bg6jji/si4732Radio/SI4732_MEGA1284/TYPEC接口.png

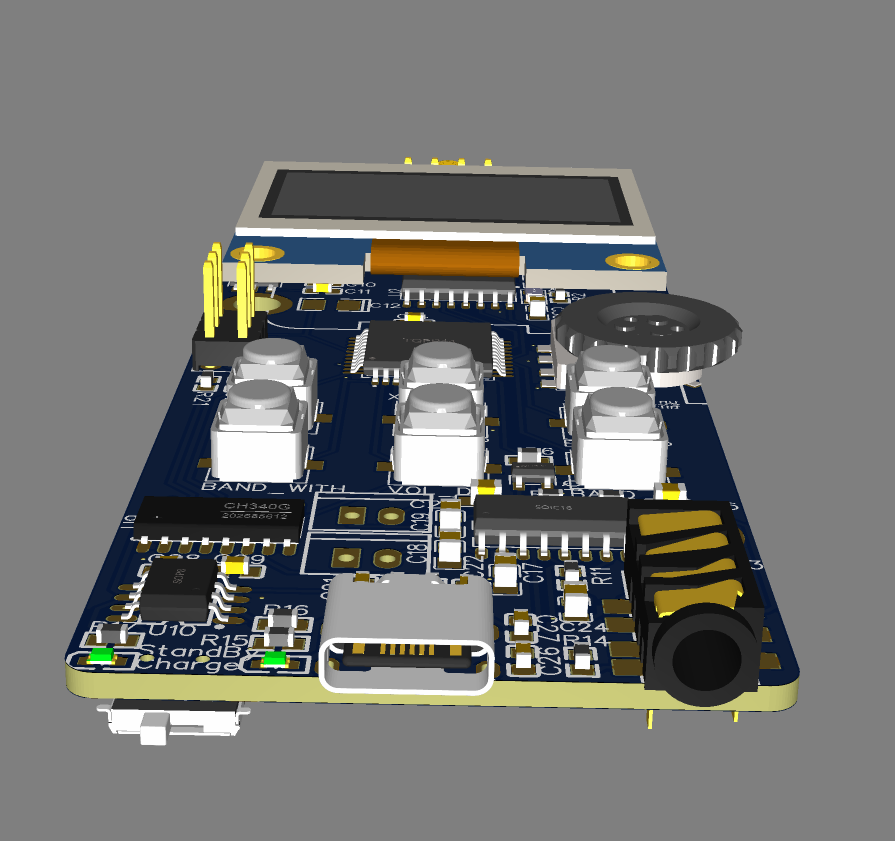
SI4732_MEGA1284/TYPEC接口.png
