bg6jji/si4732Radio/SI4732_MEGA1284/侧面.png

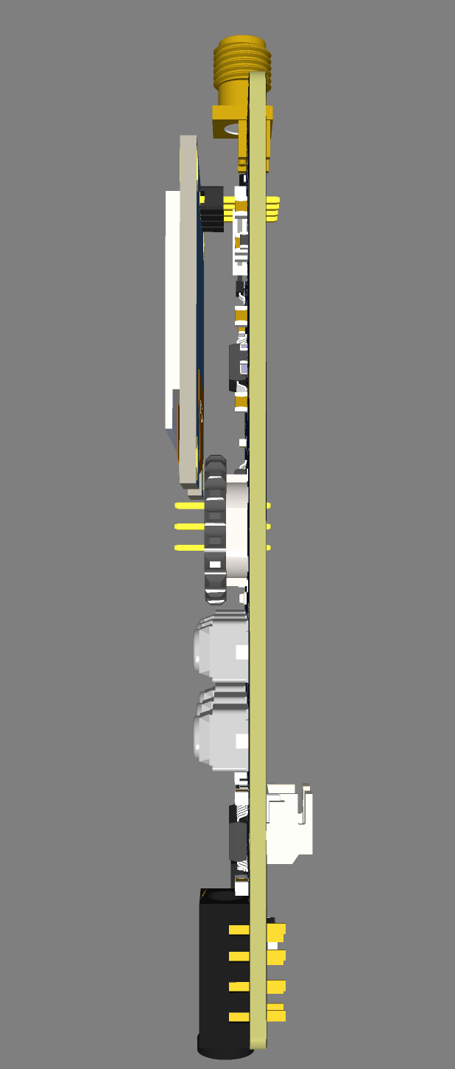
SI4732_MEGA1284/侧面.png
