bg6jji/si4732Radio/SI4732_MEGA1284/天线接口.png

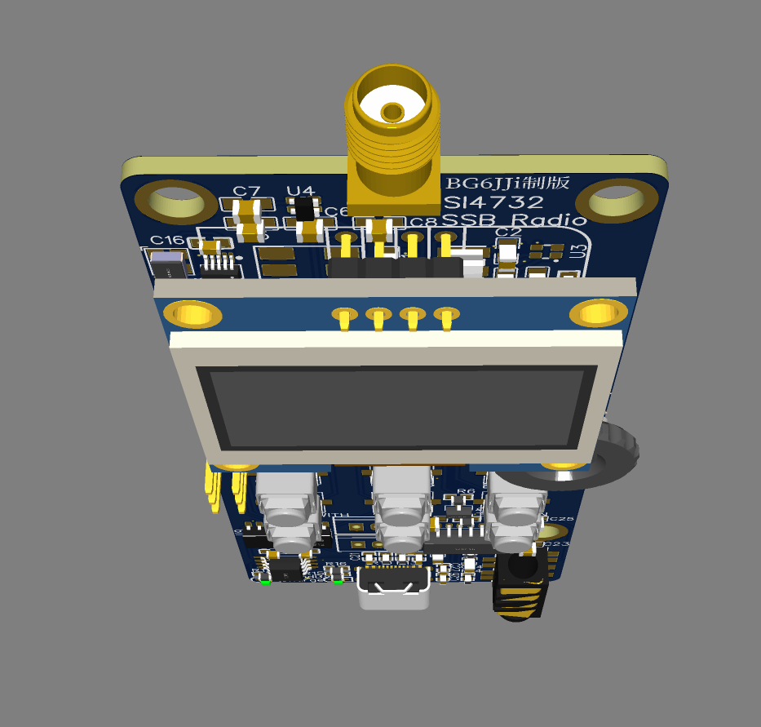
SI4732_MEGA1284/天线接口.png
