bg6jji/si4732Radio/SI4732_MEGA1284/背面.png

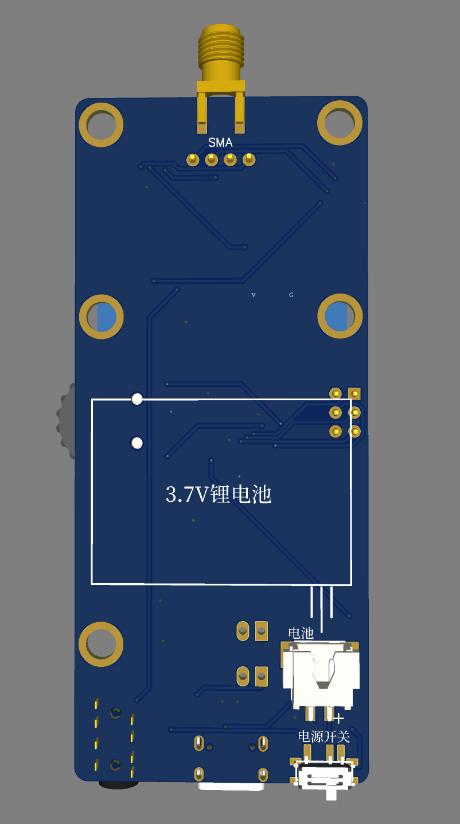
SI4732_MEGA1284/背面.png
