bg6jji/si4732Radio/第一版照片参考/侧面.png

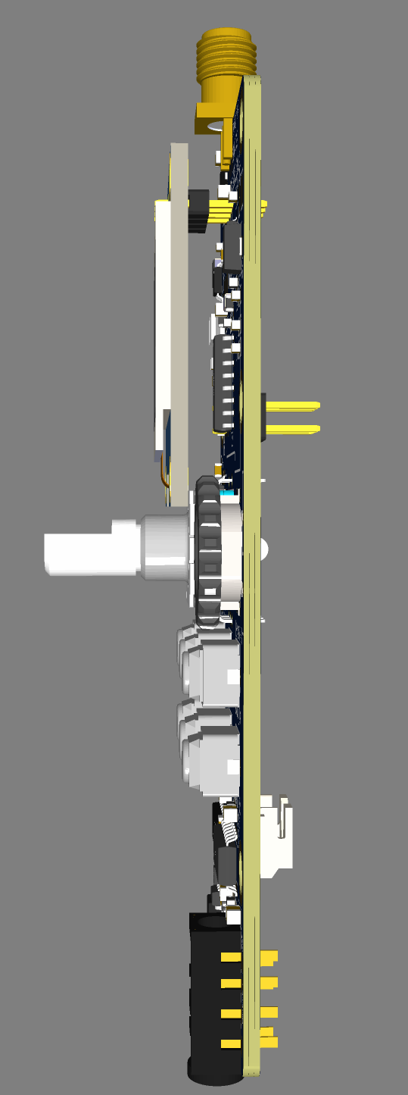
第一版照片参考/侧面.png
