bg6jji/si4732Radio/第一版照片参考/实物照片1.jpg

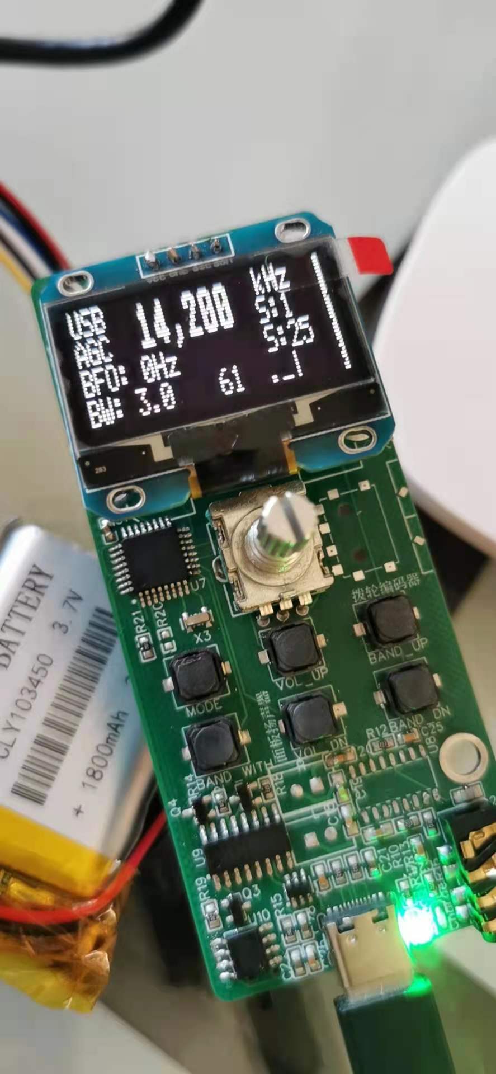
第一版照片参考/实物照片1.jpg
