bg6jji/si4732Radio/第一版照片参考/底部插口.png

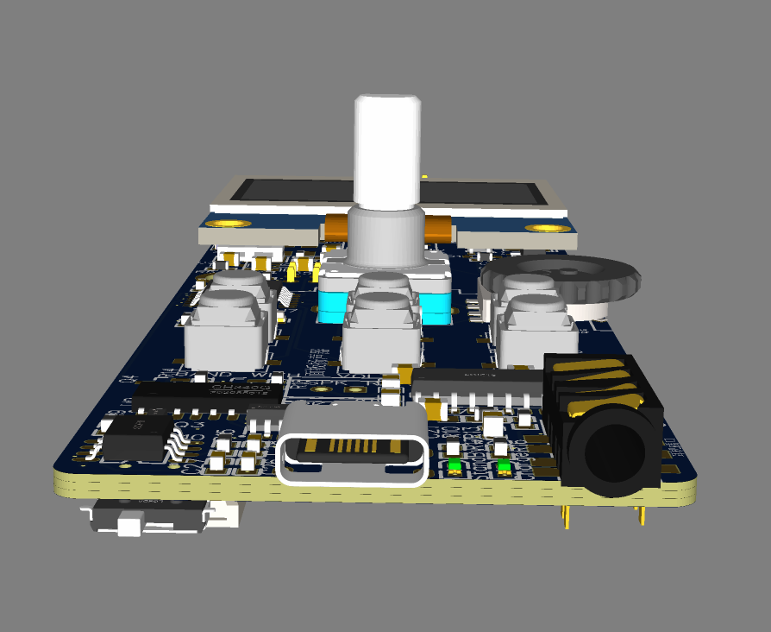
第一版照片参考/底部插口.png
