bg6jji/si4732Radio/第一版照片参考/正面实物图.jpg

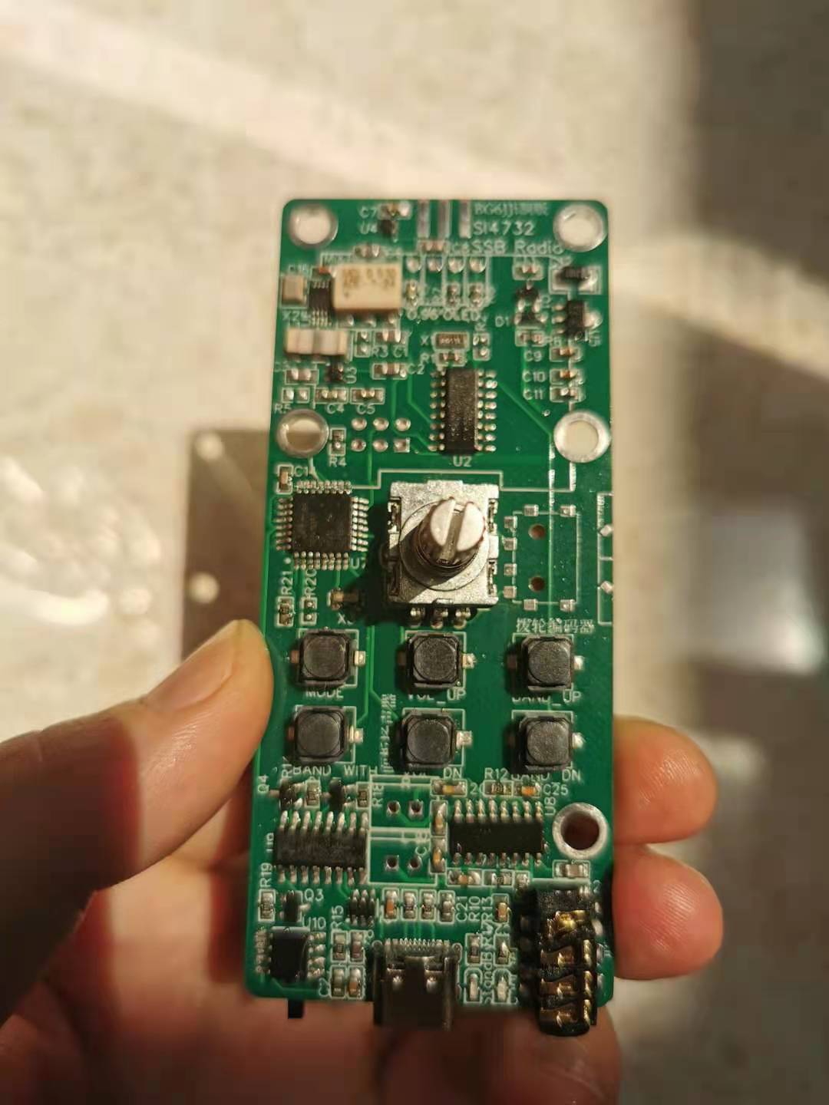
第一版照片参考/正面实物图.jpg
