bg6jji/si4732Radio/第一版照片参考/背面.png

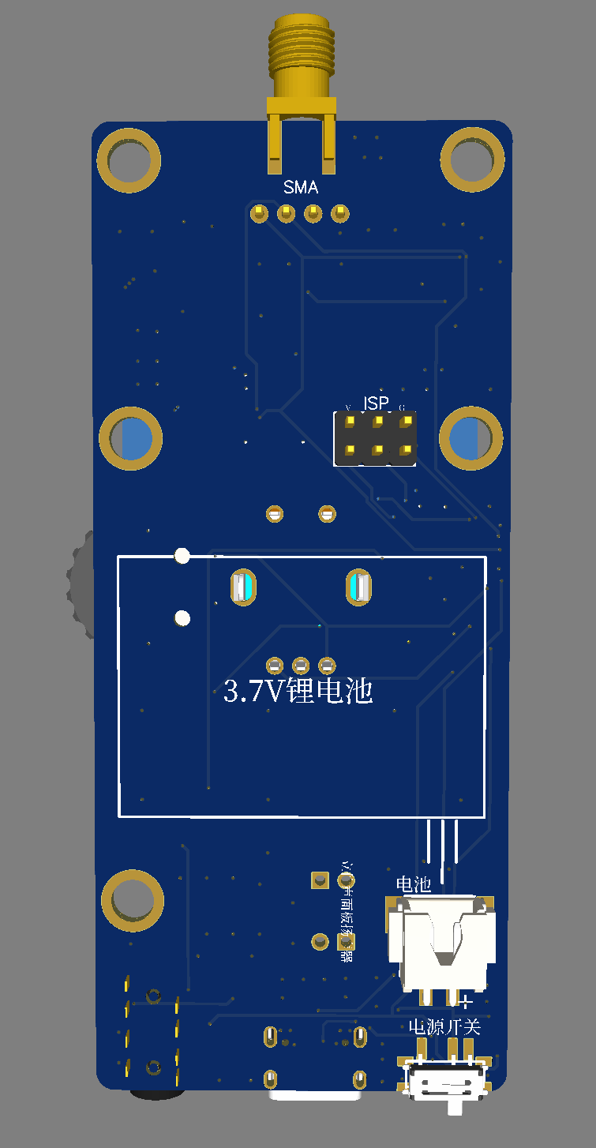
第一版照片参考/背面.png
