bg6jji/si4732Radio/Gerber_File/BOM_PCB_4732 radio_2021-08-25.csv

ID | Name | Designator | Footprint | Quantity | Manufacturer Part | Manufacturer | Supplier | Supplier Part | Price
1 | 电池 | CN1 | CONN-SMD_2.54-2PWT | 1 | 2.54-2P WT | SHOU HAN | LCSC | C668622 | 0.4457
2 | S8050 | Q1 | SOT-23-3_L2.9-W1.3-P1.90-LS2.4-BR | 1 | S8050 | JSMSEMI | LCSC | C916390 | 0.0719
3 | 1K | R13,R10,R11,R12,R14 | R0603 | 5
4 | ISP | J2 | HDR-M-2.54_2X3 | 1 |  |  | LCSC | C65114 | 0.1546
5 | 10pF | C1,C2 | C0805 | 2 | - | Samsung Electro-Mechanics | LCSC | C16036 | 0.02
6 | 18pf | C3 | C0805 | 1 | - | Samsung Electro-Mechanics | LCSC | C16036 | 0.02
7 | 1nF | C4,C11,C12,C13,C14 | C0805 | 5 | - | Samsung Electro-Mechanics | LCSC | C16036 | 0.02
8 | 470nF | C5 | C0805 | 1 | - | Samsung Electro-Mechanics | LCSC | C16036 | 0.02
9 | 100nF | C6,C15,C20,C21 | C0603 | 4
10 | 2.2uF | C7 | C0603 | 1
11 | 10uF | C8,C16,C22 | C0603 | 3
12 | 220uF | C9 | CASE-B_3528 | 1 | CA45-B-6.3V-100uF-K | CEC | LCSC | C129289 | 0.9516
13 | 100nF | C10 | C0603 | 1
14 | 100pF | C17 | C0805 | 1 | - | Samsung Electro-Mechanics | LCSC | C16036 | 0.02
15 | 1uF | C18,C19 | C0805 | 2
16 | 10u | C23 | C0603 | 1
17 | BAV199 | D1,D2 | SOT-23-3_L3.0-W1.7-P0.95-LS2.9-BR | 2 | BAV199 | CJ | LCSC | C68971 | 0.1549
18 | SPK_L | JP1 | XH2.54-2P | 1 | 2P
19 | SPK_R | JP2 | XH2.54-2P | 1 | 2P
20 | BAND | KEY1 | MSK-11027 | 1 | MSK12C02 | SHOU HAN | LCSC | C431540 | 0.2789
21 | 10K | R2 | R0603 | 1
22 | 4.7K | R4,R3 | R0603 | 2
23 | 5.1K | R6,R9 | R0603 | 2
24 | FM | RF1 | SMA-SMD_BWSMA-KE-P001 | 1 | HJ-SMA275 | 皇捷 | LCSC | C2693809 | 5.98
25 | AM | RF2 | SMA-SMD_BWSMA-KE-P001 | 1 | HJ-SMA275 | 皇捷 | LCSC | C2693809 | 5.98
26 | DC SW | SW8 | SW-TH_TK-6580A-1 | 1 | TK-6580A-1 | Yuandi(台湾元迪) | LCSC | C528770 | 1.2415
27 | ATMEGA328 | U4 | TQFP-32_L7.0-W7.0-P0.80-LS9.0-BL | 1 | ATMEGA328PB-AU | MICROCHIP | LCSC | C132230 | 17.44
28 | PAM8406DR | U5 | SOIC-16_L9.9-W3.9-P1.27-LS6.0-BL | 1 | PAM8406DR | DIODES | LCSC | C86270 | 2.67
29 | CH340C | U6 | SOP-16_150MIL | 1 | CH340C | WCH | LCSC | C84681 | 4.15
30 | TP4056X | U7 | SOP-8_L4.9-W3.9-P1.27-LS6.0-BL-EP | 1 | TP4056X | Nanjing Extension Microelectronics | LCSC | C191323 | 1.2236
31 | 8MHz | X2 | OSC-SMD_3P-L3.2-W1.3-P1.2-L | 1 | CSTCE20M0V53-R0 | MuRata | LCSC | C91586 | 1.652
32 | 100nF | C24 | C0805 | 1 | - | Samsung Electro-Mechanics | LCSC | C16036 | 0.02
33 | 300uH | MW | IND-SMD_L5.0-W5.0_FNR50XXS | 1 | FNR5040S301MT | cjiang | LCSC | C167982 | 0.4936
34 | 47uH | SW | IND-SMD_L5.0-W5.0 | 1 | CKCS5020-47uH/M | CENKER | LCSC | C354600 | 0.3356
35 | 270uH | FM | IND-SMD_L5.0-W5.0_FNR50XXS | 1 | FNR5040S301MT | cjiang | LCSC | C167982 | 0.4936
36 | VOL_DN | SW4 | SW-SMD_L6.0-W6.0-LS6.6 | 1 | SPEH110100 | ALPS Electric | LCSC | C97448 | 6.45
37 | VOL_UP | SW5 | SW-SMD_L6.0-W6.0-LS6.6 | 1 | SPEH110100 | ALPS Electric | LCSC | C97448 | 6.45
38 | BAND_DN | SW6 | SW-SMD_L6.0-W6.0-LS6.6 | 1 | SPEH110100 | ALPS Electric | LCSC | C97448 | 6.45
39 | BAND_UP | SW7 | SW-SMD_L6.0-W6.0-LS6.6 | 1 | SPEH110100 | ALPS Electric | LCSC | C97448 | 6.45
40 | 耳机插口 | U1 | PJ-3930-8P | 1
41 | SI4732-A10-GSR | U2 | SOIC-16_L9.9-W3.9-P1.27-LS6.0-BL | 1 | SI4732-A10-GSR | SILICON LABS(芯科) | LCSC | C2155558 | 12.25
42 | 拨轮编码器 | K1 | SIQ-02FVS3 | 1
43 | 32.768KHZ | X1 | OSC-SMD_L3.2-W1.5 | 1 | X321532768KGD2SI | Yangxing Tech | LCSC | C620155 | 2.7
44 | Charge | LED1 | LED0603-R-RD | 1 | E6C0603URAC1UDA | EKINGLUX | LCSC | C375444 | 0.0808
45 | StandBy | LED2 | LED0603-R-RD | 1 | ORH-G36G | Orient | LCSC | C205443 | 0.0561
46 | KH-TYPE-C-16P | USB1 | USB-C-SMD_KH-TYPE-C-16P | 1 | KH-TYPE-C-16P | Shenzhen Kinghelm Elec | LCSC | C709357 | 0.4854
47 | 0.96OLED_4P | OLED1 | 0.96OLED_4P | 1 |  |  | LCSC
48 | MODE | SW2 | SW-SMD_L6.0-W6.0-LS6.6 | 1 | SPEH110100 | ALPS Electric | LCSC | C97448 | 6.45
49 | BAND_WITH | SW3 | SW-SMD_L6.0-W6.0-LS6.6 | 1 | SPEH110100 | ALPS Electric | LCSC | C97448 | 6.45
