bg6jji/si4732Radio/Gerber_File/Schematic_SI4732标准版_2021-08-25.pdf

B COM | 1 A
B

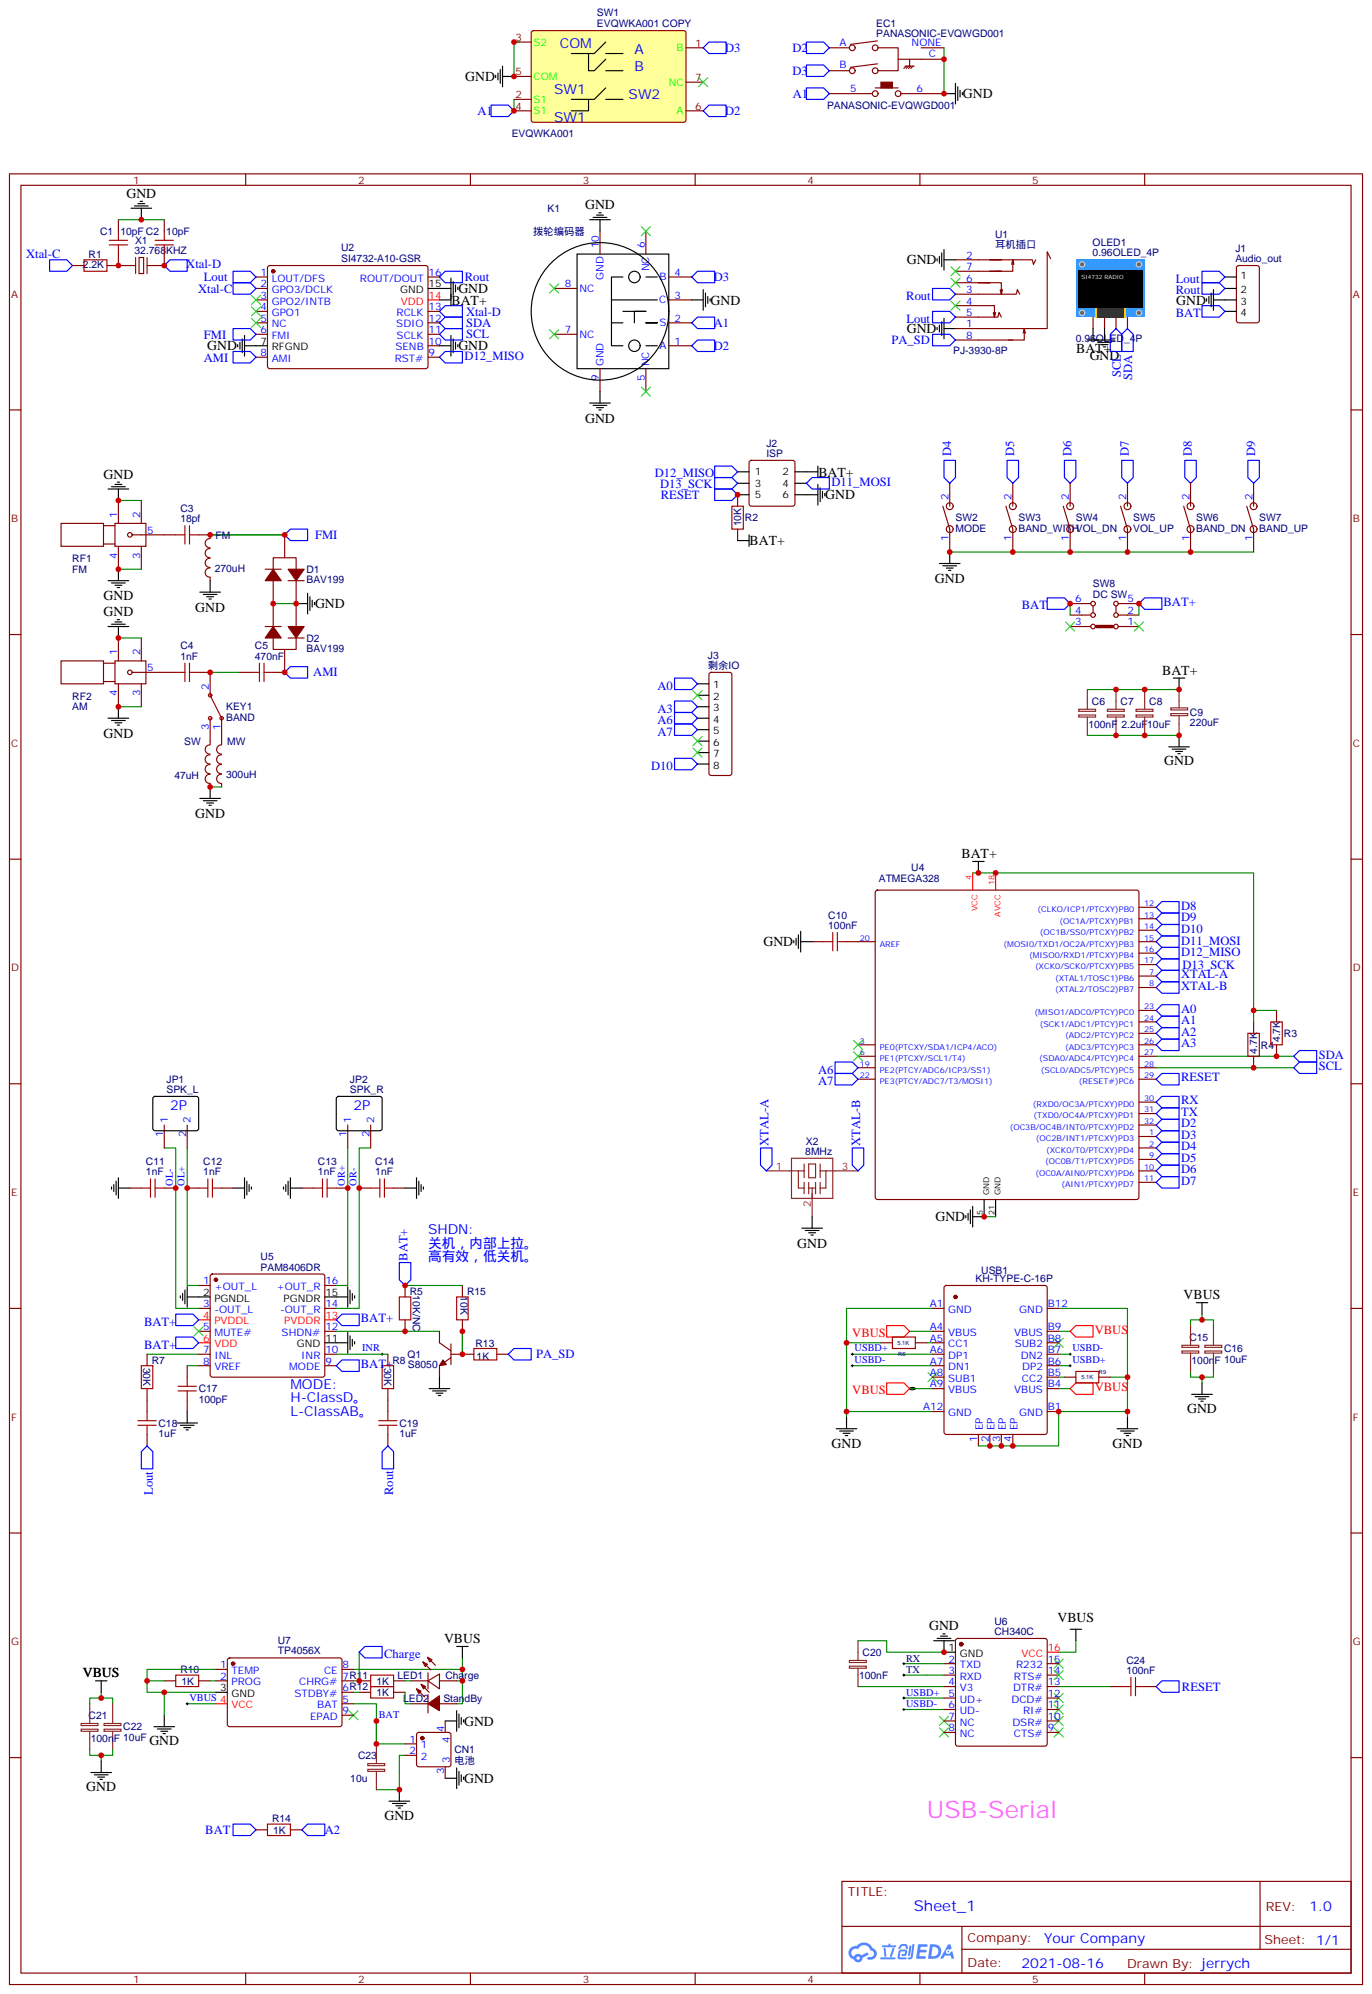
[picture p13: page 1]

DSR# 10 RI# 11 DCD# 12 DTR# 13 RTS# 14 R232 15 VCC 16
