bg6jji/si4732Radio/(commit log)

2021-08-26 Add files via upload
    第一版参考图
2021-08-26 Add files via upload
    PCB file
    Schematic file
    BOM file
    [BOM_PCB_4732 radio_2021-08-25.csv]
2021-08-26 This Version no test.这个版本未经测试。
